JinHeMu/Balance-Car/平衡小车/HARDWARE/ENCODER/encoder.c

#include "encoder.h"



void Encoder_TIM2_Init(void)
{
	GPIO_InitTypeDef GPIO_InitStruct;
	TIM_TimeBaseInitTypeDef TIM_TimeBaseInitStruct;
	TIM_ICInitTypeDef TIM_ICInitStruct;
	
	RCC_APB2PeriphClockCmd(RCC_APB2Periph_GPIOA,ENABLE);//开启时钟
	RCC_APB1PeriphClockCmd(RCC_APB1Periph_TIM2,ENABLE);
	
	GPIO_InitStruct.GPIO_Mode=GPIO_Mode_IN_FLOATING;//初始化GPIO--PA0、PA1
	GPIO_InitStruct.GPIO_Pin=GPIO_Pin_0 |GPIO_Pin_1;
	GPIO_Init(GPIOA,&GPIO_InitStruct);
	
	TIM_TimeBaseStructInit(&TIM_TimeBaseInitStruct);//初始化定时器。
	TIM_TimeBaseInitStruct.TIM_ClockDivision=TIM_CKD_DIV1;
	TIM_TimeBaseInitStruct.TIM_CounterMode=TIM_CounterMode_Up;
	TIM_TimeBaseInitStruct.TIM_Period=65535;
	TIM_TimeBaseInitStruct.TIM_Prescaler=0;
	TIM_TimeBaseInit(TIM2,&TIM_TimeBaseInitStruct);
	
	TIM_EncoderInterfaceConfig(TIM2,TIM_EncoderMode_TI12,TIM_ICPolarity_Rising,TIM_ICPolarity_Rising);//配置编码器模式
	
	TIM_ICStructInit(&TIM_ICInitStruct);//初始化输入捕获
	TIM_ICInitStruct.TIM_ICFilter=10;
	TIM_ICInit(TIM2,&TIM_ICInitStruct);
	
	TIM_ITConfig(TIM2,TIM_IT_Update,ENABLE);//配置溢出更新中断标志位
	
	TIM_SetCounter(TIM2,0);//清零定时器计数值
	
	TIM_Cmd(TIM2,ENABLE);//开启定时器
}


void Encoder_TIM3_Init(void)
{
	GPIO_InitTypeDef GPIO_InitStruct;
	TIM_TimeBaseInitTypeDef TIM_TimeBaseInitStruct;
	TIM_ICInitTypeDef TIM_ICInitStruct;
	
	RCC_APB2PeriphClockCmd(RCC_APB2Periph_GPIOA,ENABLE);
	RCC_APB1PeriphClockCmd(RCC_APB1Periph_TIM3,ENABLE);
	
	GPIO_InitStruct.GPIO_Mode=GPIO_Mode_IN_FLOATING;
	GPIO_InitStruct.GPIO_Pin=GPIO_Pin_6 |GPIO_Pin_7;
	GPIO_Init(GPIOA,&GPIO_InitStruct);
	
	TIM_TimeBaseStructInit(&TIM_TimeBaseInitStruct);
	TIM_TimeBaseInitStruct.TIM_ClockDivision=TIM_CKD_DIV1;
	TIM_TimeBaseInitStruct.TIM_CounterMode=TIM_CounterMode_Up;
	TIM_TimeBaseInitStruct.TIM_Period=65535;
	TIM_TimeBaseInitStruct.TIM_Prescaler=0;
	TIM_TimeBaseInit(TIM3,&TIM_TimeBaseInitStruct);
	
	TIM_EncoderInterfaceConfig(TIM3,TIM_EncoderMode_TI12,TIM_ICPolarity_Rising,TIM_ICPolarity_Rising);
	
	TIM_ICStructInit(&TIM_ICInitStruct);
	TIM_ICInitStruct.TIM_ICFilter=10;
	TIM_ICInit(TIM3,&TIM_ICInitStruct);
	
	TIM_ClearFlag(TIM3,TIM_FLAG_Update);
	TIM_ITConfig(TIM3,TIM_IT_Update,ENABLE);
	
	TIM_SetCounter(TIM3,0);

	TIM_Cmd(TIM3,ENABLE);
}

/**********************
编码器
速度读取函数
入口参数：定时器
**********************/
int Read_Speed(int TIMx)
{
	int value_1;
	switch(TIMx)
	{
		case 2:value_1=(short)TIM_GetCounter(TIM2);TIM_SetCounter(TIM2,0);break;//IF是定时器2，1.采集编码器的计数值并保存。2.将定时器的计数值清零。
		case 3:value_1=(short)TIM_GetCounter(TIM3);TIM_SetCounter(TIM3,0);break;
		default:value_1=0;
	}
	return value_1;
}


void TIM2_IRQHandler(void)
{
	if(TIM_GetITStatus(TIM2,TIM_IT_Update)!=0)
	{
		TIM_ClearITPendingBit(TIM2,TIM_IT_Update);
	}
}
	
void TIM3_IRQHandler(void)
{
	if(TIM_GetITStatus(TIM3,TIM_IT_Update)!=0)
	{
		TIM_ClearITPendingBit(TIM3,TIM_IT_Update);
	}
}
