JinHeMu/Balance-Car/平衡小车/HARDWARE/ENCODER/encoder.h

#ifndef  _ENCODER_H
#define  _ENCODER_H

#include "sys.h" 




void TIM2_IRQHandler(void);
void TIM3_IRQHandler(void);
int Read_Speed(int TIMx);
void Encoder_TIM2_Init(void);
void Encoder_TIM3_Init(void);
#endif
