JinHeMu/Balance-Car/(notices)

Notices in the files:
平衡小车/HARDWARE/MPU6050/mpuiic.h:
Copyright(C) ¹ãÖÝÊÐÐÇÒíµç×Ó¿Æ¼¼ÓÐÏÞ¹«Ë¾ 2009-2019
All rights reserved
